amundead/mb6-timesync-jjy/(commit log)

2026-10-15 docs: update 32-pin hardware specs, 12V LC wiring and 4m sync results
2026-10-15 Update LED wiring documentation and replace firmware with v0.4.3
    Document nine components, D25 resistor branches and common ground. Replace firmware with supplied Cloudflare/MY Pool version, remove Wi-Fi credentials, and refresh wiring comments. Preserve TX scheduling and keep sleep changes deferred.
2026-10-19 Add 04:10 deep sleep with active Manual TX deferral (v0.4.4)
    Sleep until external reset or USB power cycle; arm the next 04:10 after the first valid NTP sync so a daytime reboot stays awake. Retain a monotonic fallback after NTP loss, mute TX before stopping its timer, and hold GPIO25 LOW during sleep. Show the shutdown deadline in Web UI/status and document the behavior.
    Validation: host tests cover all 1440 boot-minute positions, deadline crossing, manual deferral, clock corrections/NTP loss, shutdown ordering/error paths, Web UI and unchanged TX schedules. ESP32 target compile and physical sleep/wake testing remain pending; the ESP32 toolchain is unavailable.
